likhith1101/Magic1000_RTL_TO_GDS_project/reports/asap7/magic1000/base/cts_default_clk_layout.webp

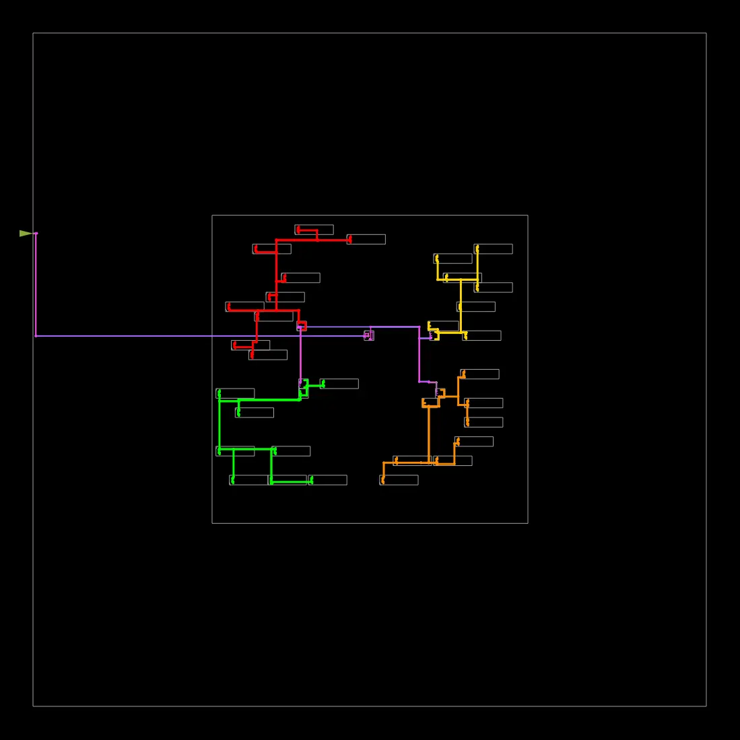
reports/asap7/magic1000/base/cts_default_clk_layout.webp
