likhith1101/Magic1000_RTL_TO_GDS_project/(list of files, drawings)

Other design files:
objects/asap7/magic1000/base/klayout.lyt
