likhith1101/Magic1000_RTL_TO_GDS_project/results/asap7/magic1000/base/6_final.v

module magic1000_core_orfs (clk,
    halt_on_nop,
    halted,
    out_valid,
    rst,
    run,
    data_addr,
    data_in,
    instr_addr,
    instr_in,
    out_a,
    out_b,
    reg0,
    reg1,
    reg2,
    reg3);
 input clk;
 input halt_on_nop;
 output halted;
 output out_valid;
 input rst;
 input run;
 output [3:0] data_addr;
 input [3:0] data_in;
 output [3:0] instr_addr;
 input [15:0] instr_in;
 output [3:0] out_a;
 output [3:0] out_b;
 output [3:0] reg0;
 output [3:0] reg1;
 output [3:0] reg2;
 output [3:0] reg3;

 wire _000_;
 wire _001_;
 wire _002_;
 wire _003_;
 wire _004_;
 wire _005_;
 wire _006_;
 wire _007_;
 wire _008_;
 wire _009_;
 wire _010_;
 wire _011_;
 wire _012_;
 wire _013_;
 wire _014_;
 wire _015_;
 wire _016_;
 wire _017_;
 wire _018_;
 wire _019_;
 wire _020_;
 wire _021_;
 wire _022_;
 wire _023_;
 wire _024_;
 wire _025_;
 wire _026_;
 wire _027_;
 wire _028_;
 wire _029_;
 wire _030_;
 wire _031_;
 wire _032_;
 wire _033_;
 wire _034_;
 wire _035_;
 wire _036_;
 wire _037_;
 wire _038_;
 wire _039_;
 wire _040_;
 wire _041_;
 wire _042_;
 wire _043_;
 wire _044_;
 wire _045_;
 wire _046_;
 wire _047_;
 wire _048_;
 wire _049_;
 wire _050_;
 wire _051_;
 wire _052_;
 wire _053_;
 wire _054_;
 wire _055_;
 wire _056_;
 wire _057_;
 wire _058_;
 wire _059_;
 wire _060_;
 wire _061_;
 wire _062_;
 wire _063_;
 wire _064_;
 wire _065_;
 wire _066_;
 wire _067_;
 wire _068_;
 wire _069_;
 wire _070_;
 wire _071_;
 wire _072_;
 wire _073_;
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
    .QN(_021_));
 DFFHQNx1_ASAP7_75t_R \register_file.regs[3][3]$_DFFE_PP_  (.CLK(clknet_2_1__leaf_clk),
    .D(_076_),
    .QN(_009_));
 assign data_addr[0] = instr_in[0];
 assign data_addr[1] = instr_in[1];
 assign data_addr[2] = instr_in[2];
 assign data_addr[3] = instr_in[3];
endmodule
